marekw1986/Z80_computer/hardware/CPU_board/Z80.brd

## EAGLE design hardware/CPU_board/Z80.brd (2025-04-28)

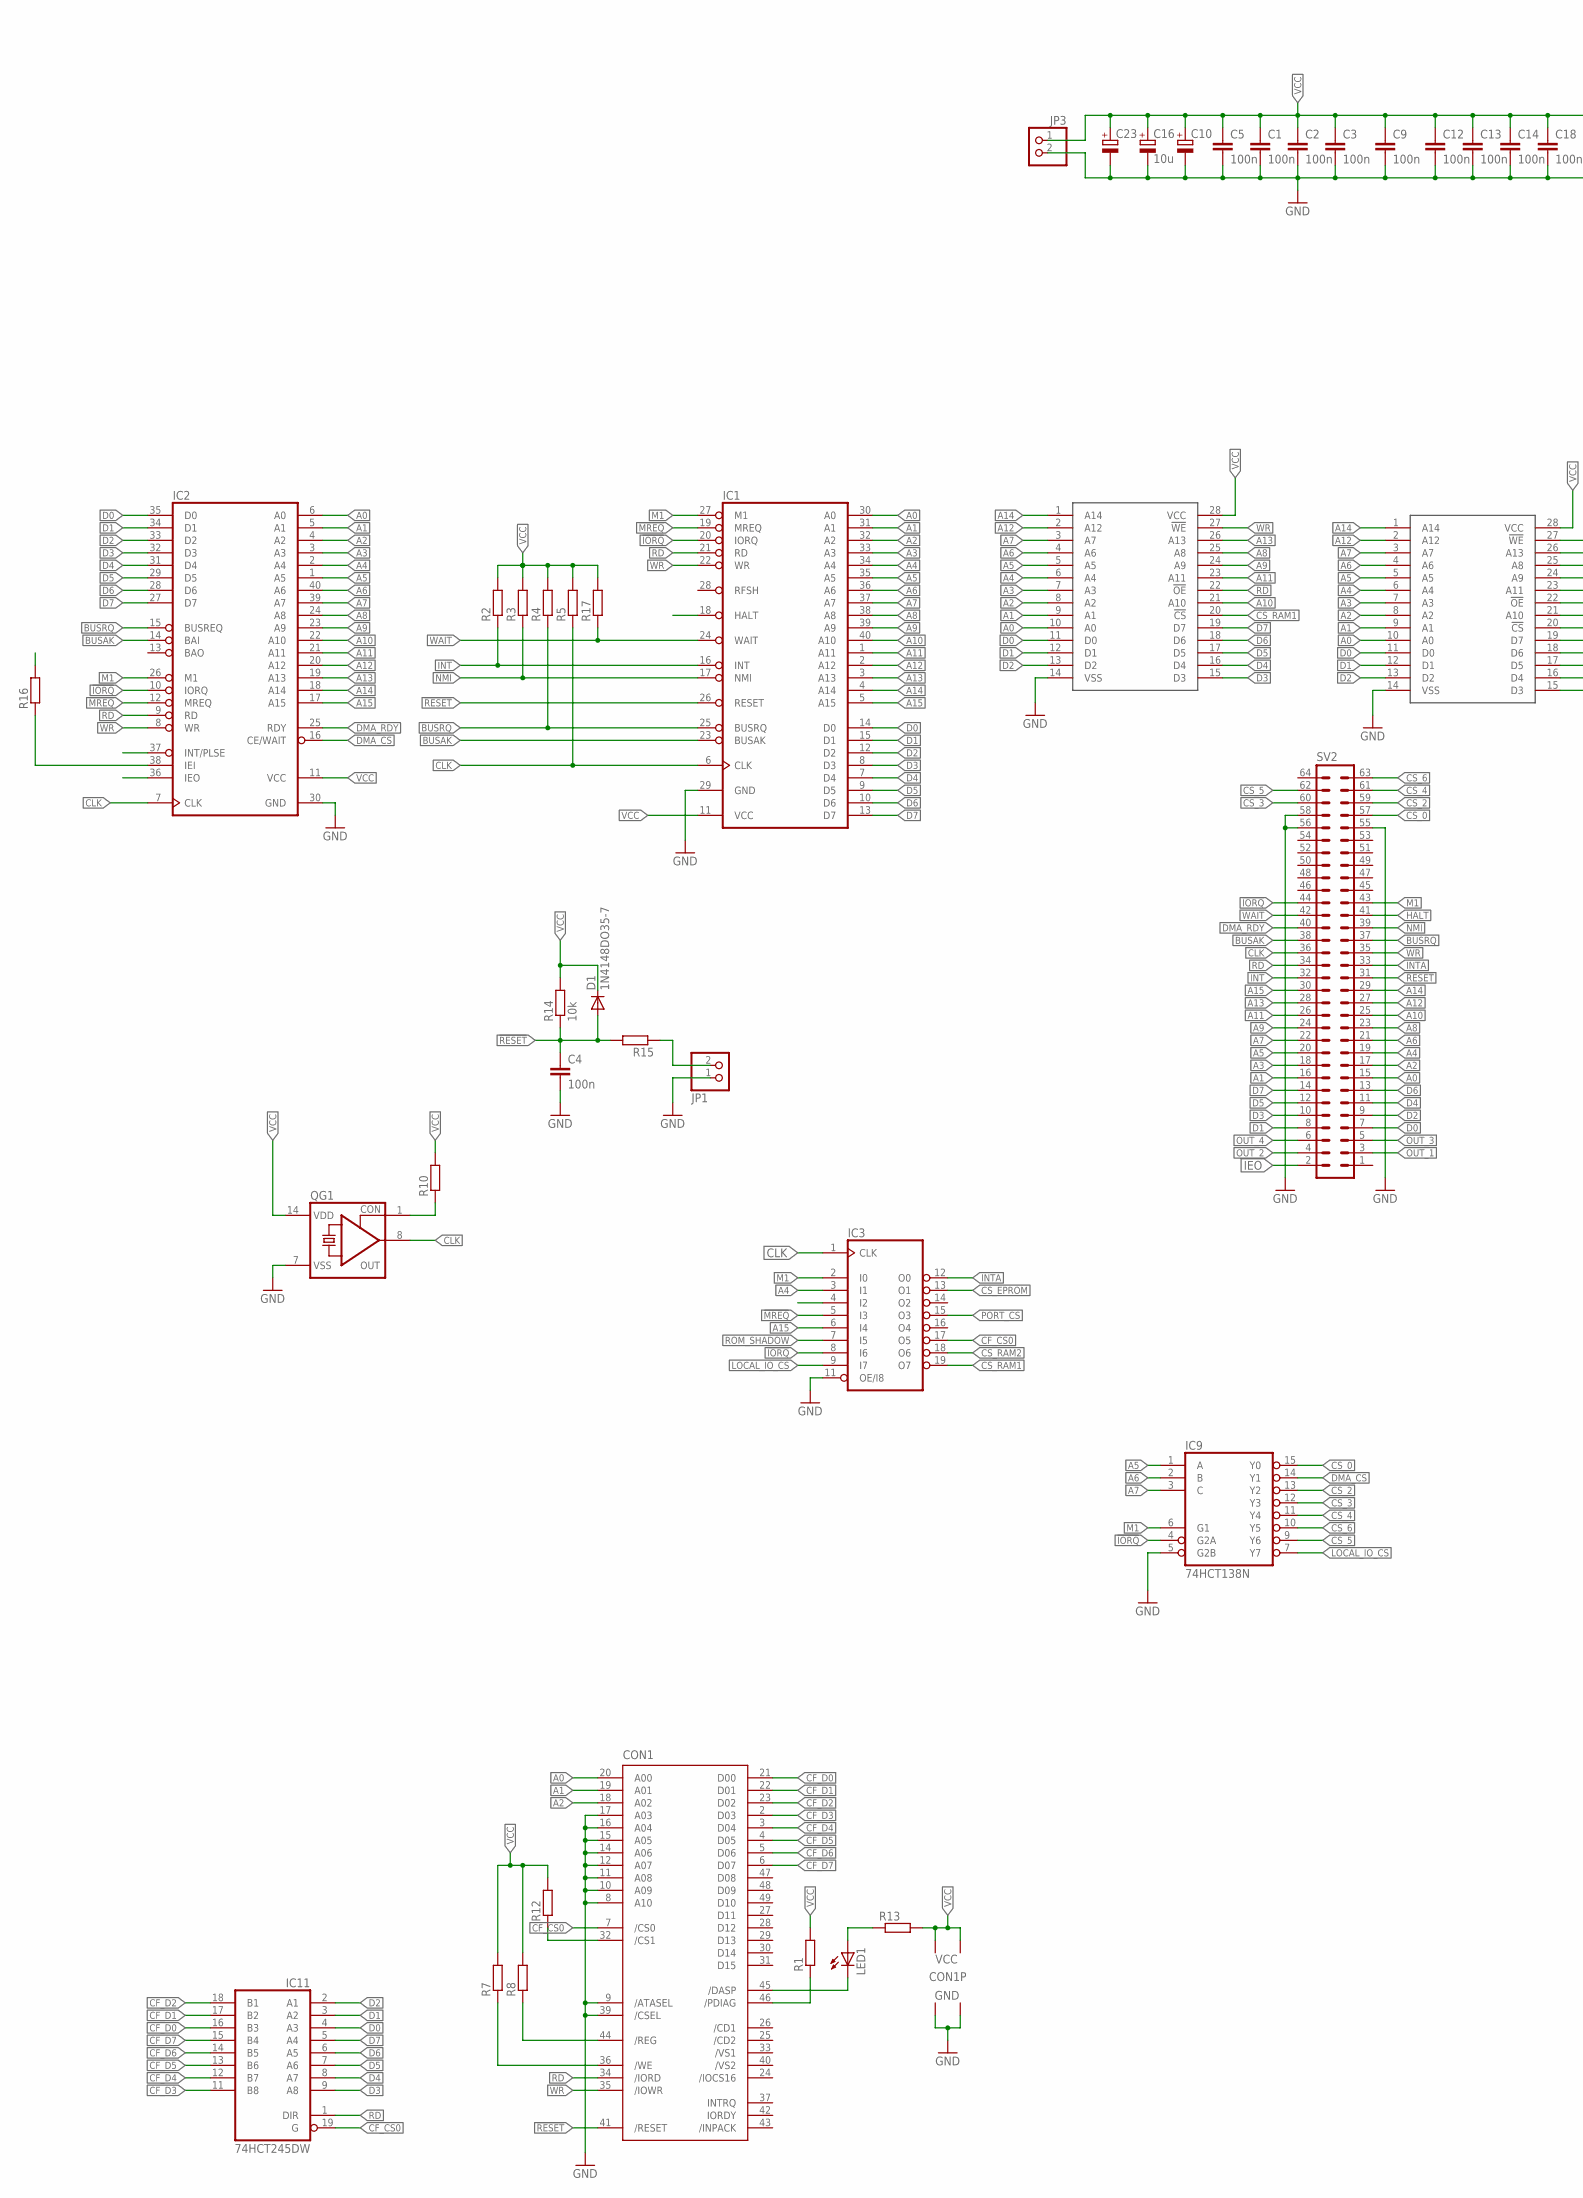
[picture p1: schematic Z80.sch, part in row 1, column 1]

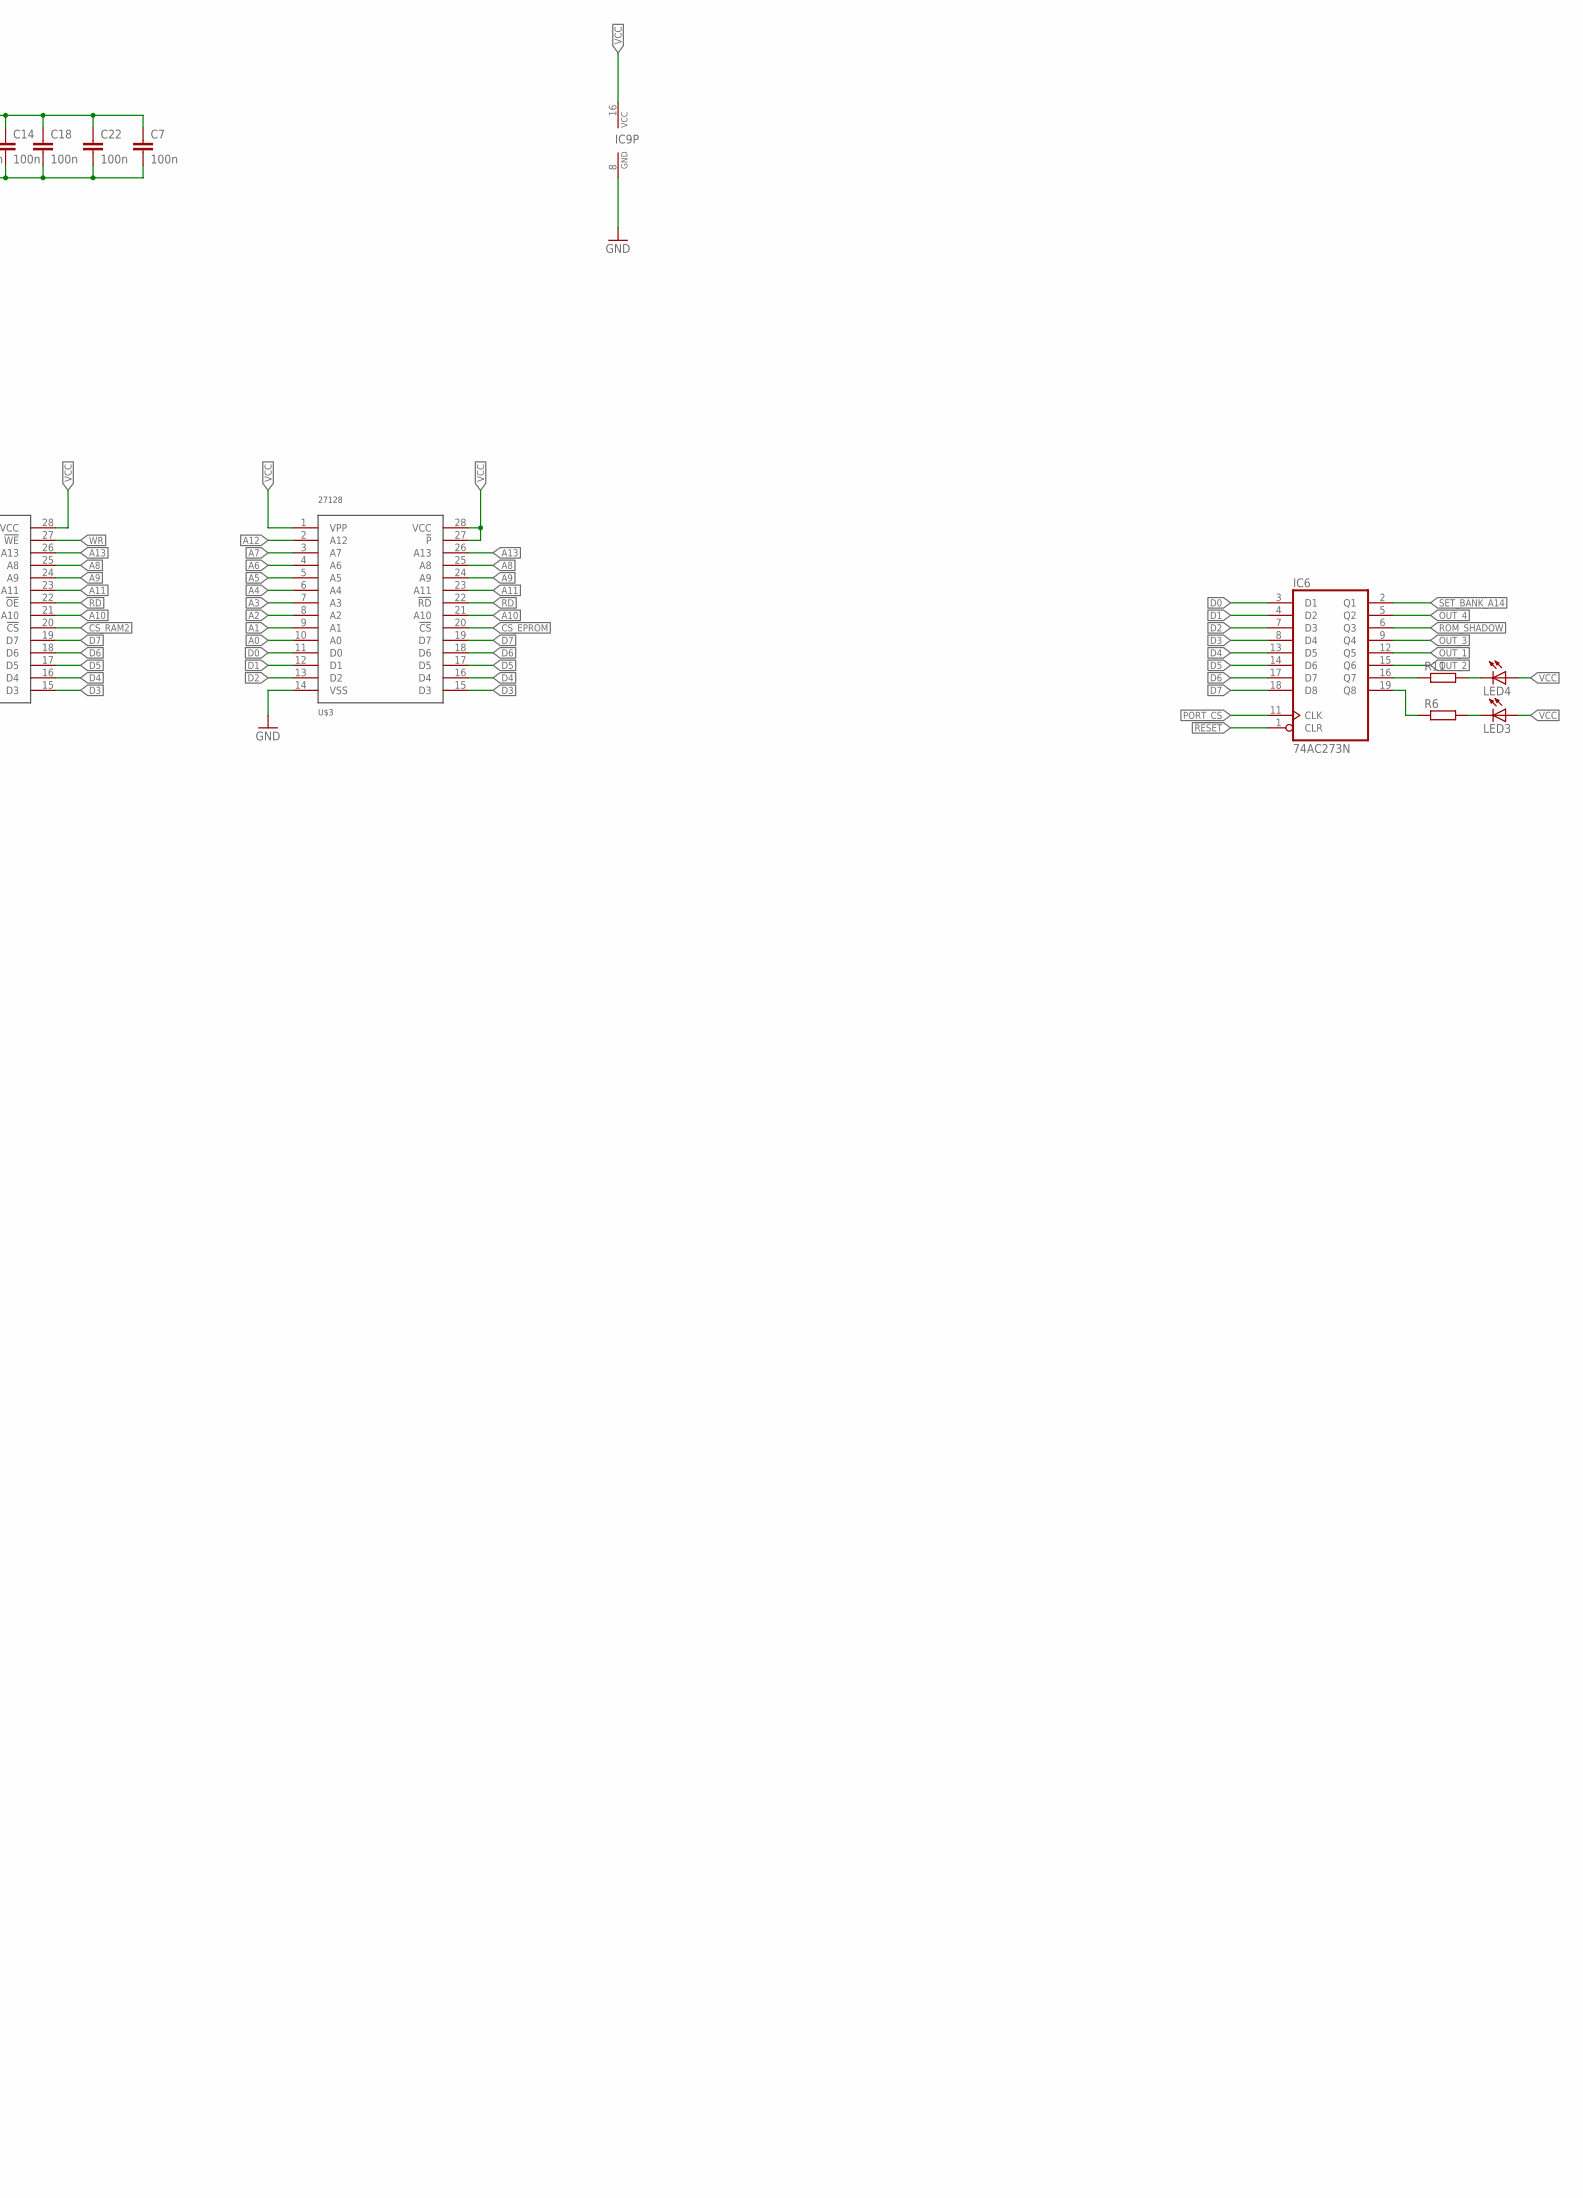
[picture p2: schematic Z80.sch, part in row 1, column 2]

Parts:
C1, C2, C3, C9, C14: 100n; C1206
C4, C7, C18, C22: 100n; C0603
C5: 100n; C050-024X044
C10, C23: CPOL-EUE5-10.5; E5-10,5
C12, C13: 100n; C0805
C16: 10u; SMC_B
CON1: CF-CARD-IDE_MODE; MI20-50PD-SF
D1: 1N4148DO35-7; DO35-7
IC1: Z80CPU; DIL40
IC2: Z80DMA; DIL40
IC3: 16V8; DIL20
IC6: 74AC273N; DIL20
IC9: 74HCT138N; DIL16
IC11: 74HCT245DW; SO20W
JP1, JP3: PINHD-1X2; 1X02
LED1, LED3, LED4: LED5MM
QG1: CRYSTAL_RES-SG51; SG51
R1, R8: R-EU_0204/7; 0204/7
R2, R3, R6, R11: R-EU_R1206; R1206
R4, R5, R10, R13, R15, R17: R-EU_R0603; R0603
R7, R12: R-EU_0207/10; 0207/10
R14: 10k; 0204/7
R16: R-EU_0204/5; 0204/5
SV2: ML64L
U$2, U$4: 62256; DIL28-6
U$3: 27128; DIL28

Connections:
!IORQ: IC1.20 (IORQ), IC2.10 (IORQ), IC3.8 (I6), IC9.4 (G2A), SV2.44
!MREQ: IC1.19 (MREQ), IC2.12 (MREQ), IC3.5 (I3)
!RESET: C4.1, CON1.41 (/RESET), D1.A, IC1.26 (RESET), IC6.1 (CLR), R14.1, R15.2, SV2.31
A0: CON1.20 (A00), IC1.30 (A0), IC2.6 (A0), SV2.15, U$2.10 (A0), U$3.10 (A0), U$4.10 (A0)
A1: CON1.19 (A01), IC1.31 (A1), IC2.5 (A1), SV2.16, U$2.9 (A1), U$3.9 (A1), U$4.9 (A1)
A2: CON1.18 (A02), IC1.32 (A2), IC2.4 (A2), SV2.17, U$2.8 (A2), U$3.8 (A2), U$4.8 (A2)
A3: IC1.33 (A3), IC2.3 (A3), SV2.18, U$2.7 (A3), U$3.7 (A3), U$4.7 (A3)
A4: IC1.34 (A4), IC2.2 (A4), IC3.3 (I1), SV2.19, U$2.6 (A4), U$3.6 (A4), U$4.6 (A4)
A5: IC1.35 (A5), IC2.1 (A5), IC9.1 (A), SV2.20, U$2.5 (A5), U$3.5 (A5), U$4.5 (A5)
A6: IC1.36 (A6), IC2.40 (A6), IC9.2 (B), SV2.21, U$2.4 (A6), U$3.4 (A6), U$4.4 (A6)
A7: IC1.37 (A7), IC2.39 (A7), IC9.3 (C), SV2.22, U$2.3 (A7), U$3.3 (A7), U$4.3 (A7)
A8: IC1.38 (A8), IC2.24 (A8), SV2.23, U$2.25 (A8), U$3.25 (A8), U$4.25 (A8)
A9: IC1.39 (A9), IC2.23 (A9), SV2.24, U$2.24 (A9), U$3.24 (A9), U$4.24 (A9)
A10: IC1.40 (A10), IC2.22 (A10), SV2.25, U$2.21 (A10), U$3.21 (A10), U$4.21 (A10)
A11: IC1.1 (A11), IC2.21 (A11), SV2.26, U$2.23 (A11), U$3.23 (A11), U$4.23 (A11)
A12: IC1.2 (A12), IC2.20 (A12), SV2.27, U$2.2 (A12), U$3.2 (A12), U$4.2 (A12)
A13: IC1.3 (A13), IC2.19 (A13), SV2.28, U$2.26 (A13), U$3.26 (A13), U$4.26 (A13)
A14: IC1.4 (A14), IC2.18 (A14), SV2.29, U$2.1 (A14), U$4.1 (A14)
A15: IC1.5 (A15), IC2.17 (A15), IC3.6 (I4), SV2.30
BUSAK: IC1.23 (BUSAK), IC2.14 (BAI), SV2.38
BUSRQ: IC1.25 (BUSRQ), IC2.15 (BUSREQ), R4.1, SV2.37
CF_CS0: CON1.7 (/CS0), IC3.17 (O5), IC11.19 (G)
CF_D0: CON1.21 (D00), IC11.16 (B3)
CF_D1: CON1.22 (D01), IC11.17 (B2)
CF_D2: CON1.23 (D02), IC11.18 (B1)
CF_D3: CON1.2 (D03), IC11.11 (B8)
CF_D4: CON1.3 (D04), IC11.12 (B7)
CF_D5: CON1.4 (D05), IC11.13 (B6)
CF_D6: CON1.5 (D06), IC11.14 (B5)
CF_D7: CON1.6 (D07), IC11.15 (B4)
CLK: IC1.6 (CLK), IC2.7 (CLK), IC3.1 (CLK), QG1.8 (OUT), R5.1, SV2.36
CS_0: IC9.15 (Y0), SV2.57
CS_2: IC9.13 (Y2), SV2.59
CS_3: IC9.12 (Y3), SV2.60
CS_4: IC9.11 (Y4), SV2.61
CS_5: IC9.9 (Y6), SV2.62
CS_6: IC9.10 (Y5), SV2.63
CS_EPROM: IC3.13 (O1), U$3.20 (!CS)
CS_RAM1: IC3.19 (O7), U$4.20 (!CS)
CS_RAM2: IC3.18 (O6), U$2.20 (!CS)
D0: IC1.14 (D0), IC2.35 (D0), IC6.3 (D1), IC11.4 (A3), SV2.7, U$2.11 (D0), U$3.11 (D0), U$4.11 (D0)
D1: IC1.15 (D1), IC2.34 (D1), IC6.4 (D2), IC11.3 (A2), SV2.8, U$2.12 (D1), U$3.12 (D1), U$4.12 (D1)
D2: IC1.12 (D2), IC2.33 (D2), IC6.7 (D3), IC11.2 (A1), SV2.9, U$2.13 (D2), U$3.13 (D2), U$4.13 (D2)
D3: IC1.8 (D3), IC2.32 (D3), IC6.8 (D4), IC11.9 (A8), SV2.10, U$2.15 (D3), U$3.15 (D3), U$4.15 (D3)
D4: IC1.7 (D4), IC2.31 (D4), IC6.13 (D5), IC11.8 (A7), SV2.11, U$2.16 (D4), U$3.16 (D4), U$4.16 (D4)
D5: IC1.9 (D5), IC2.29 (D5), IC6.14 (D6), IC11.7 (A6), SV2.12, U$2.17 (D5), U$3.17 (D5), U$4.17 (D5)
D6: IC1.10 (D6), IC2.28 (D6), IC6.17 (D7), IC11.6 (A5), SV2.13, U$2.18 (D6), U$3.18 (D6), U$4.18 (D6)
D7: IC1.13 (D7), IC2.27 (D7), IC6.18 (D8), IC11.5 (A4), SV2.14, U$2.19 (D7), U$3.19 (D7), U$4.19 (D7)
DMA_CS: IC2.16 (CE/WAIT), IC9.14 (Y1)
DMA_RDY: IC2.25 (RDY), SV2.40
GND: C1.2, C2.2, C3.2, C4.2, C5.2, C7.2, C9.2, C10.-, C12.2, C13.2, C14.2, C16.-, C18.2, C22.2, C23.-, CON1.1 (GND1), CON1.8 (A10), CON1.9 (/ATASEL), CON1.10 (A09), CON1.11 (A08), CON1.12 (A07), CON1.14 (A06), CON1.15 (A05), CON1.16 (A04), CON1.17 (A03), CON1.39 (/CSEL), CON1.50 (GND2), IC1.29 (GND), IC2.30 (GND), IC3.10 (GND), IC3.11 (OE/I8), IC6.10 (GND), IC9.5 (G2B), IC9.8 (GND), IC11.10 (GND), JP1.1, JP3.2, QG1.7 (VSS), SV2.55, SV2.56, SV2.58, U$2.14 (VSS), U$3.14 (VSS), U$4.14 (VSS)
HALT: IC1.18 (HALT), SV2.41
IEO: IC2.36 (IEO), SV2.2
INT: IC1.16 (INT), IC2.37 (INT/PLSE), R2.1, SV2.32
INTA: IC3.12 (O0), SV2.33
LOCAL_IO_CS: IC3.9 (I7), IC9.7 (Y7)
M1: IC1.27 (M1), IC2.26 (M1), IC3.2 (I0), IC9.6 (G1), SV2.43
unnamed: QG1.1 (CON), R10.1
unnamed: JP1.2, R15.1
unnamed: IC2.38 (IEI), R16.1
unnamed: IC6.16 (Q7), R11.1
unnamed: LED3.K (C), R6.2
unnamed: LED4.K (C), R11.2
unnamed: IC6.19 (Q8), R6.1
unnamed: CON1.44 (/REG), R8.1
unnamed: CON1.36 (/WE), R7.1
unnamed: CON1.46 (/PDIAG), R1.1
unnamed: LED1.A, R13.1
unnamed: CON1.45 (/DASP), LED1.K (C)
unnamed: CON1.32 (/CS1), R12.1
NMI: IC1.17 (NMI), R3.1, SV2.39
OUT_1: IC6.12 (Q5), SV2.3
OUT_2: IC6.15 (Q6), SV2.4
OUT_3: IC6.9 (Q4), SV2.5
OUT_4: IC6.5 (Q2), SV2.6
PORT_CS: IC3.15 (O3), IC6.11 (CLK)
RD: CON1.34 (/IORD), IC1.21 (RD), IC2.9 (RD), IC11.1 (DIR), SV2.34, U$2.22 (!OE), U$3.22 (!RD), U$4.22 (!OE)
ROM_SHADOW: IC3.7 (I5), IC6.6 (Q3)
SET_BANK_A14: IC6.2 (Q1)
VCC: C1.1, C2.1, C3.1, C5.1, C7.1, C9.1, C10.+, C12.1, C13.1, C14.1, C16.+, C18.1, C22.1, C23.+, CON1.13 (VCC2), CON1.38 (VCC1), D1.C, IC1.11 (VCC), IC2.11 (VCC), IC3.20 (VCC), IC6.20 (VCC), IC9.16 (VCC), IC11.20 (VCC), JP3.1, LED3.A, LED4.A, QG1.14 (VDD), R1.2, R2.2, R3.2, R4.2, R5.2, R7.2, R8.2, R10.2, R12.2, R13.2, R14.2, R16.2, R17.2, U$2.28 (VCC), U$3.1 (VPP), U$3.27 (!P), U$3.28 (VCC), U$4.28 (VCC)
WAIT: IC1.24 (WAIT), R17.1, SV2.42
WR: CON1.35 (/IOWR), IC1.22 (WR), IC2.8 (WR), IC3.4 (I2), SV2.35, U$2.27 (!WE), U$4.27 (!WE)

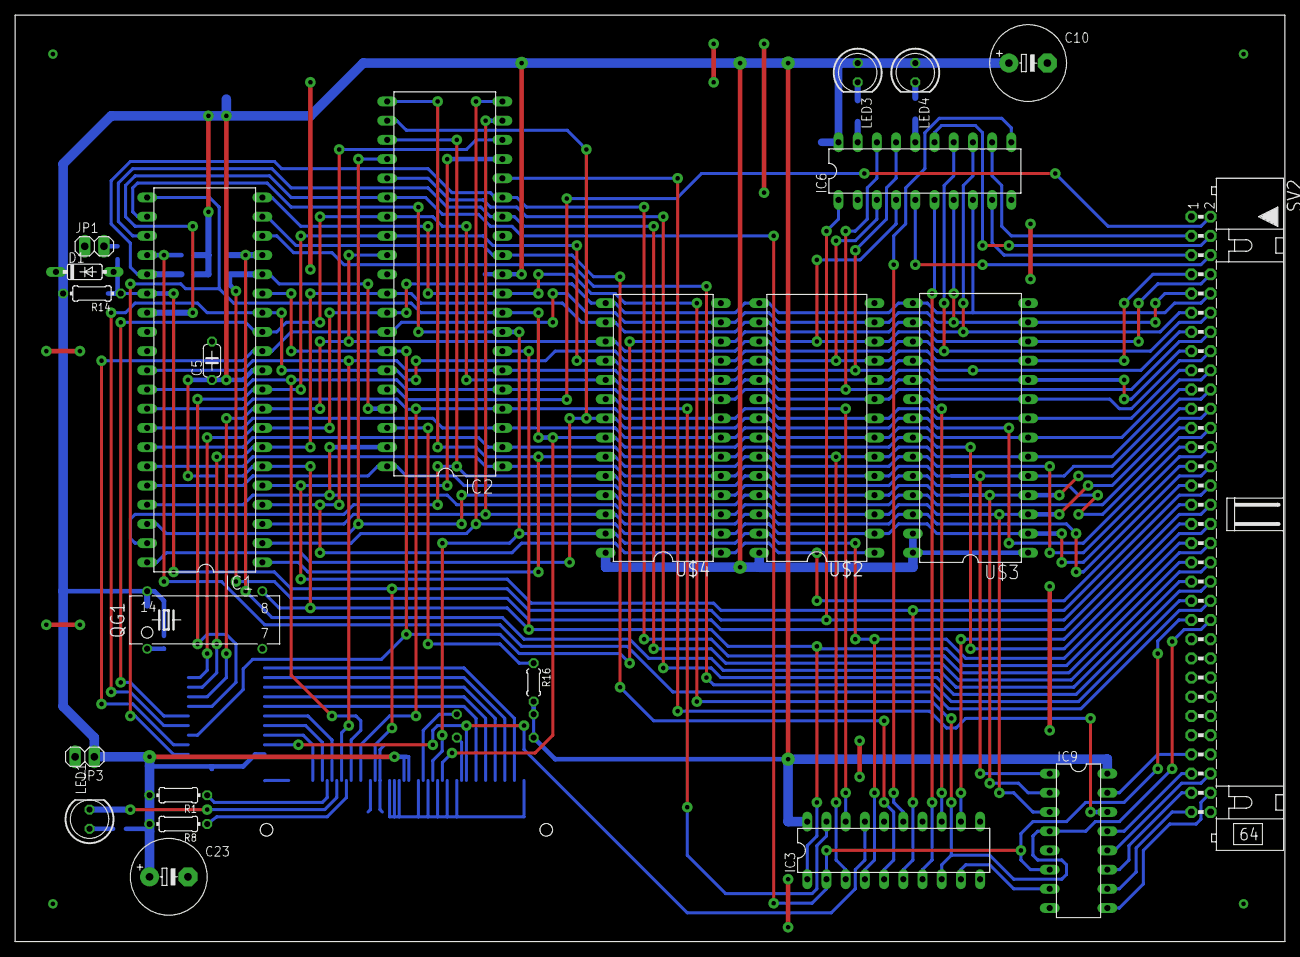
[picture p3: board Z80.brd from above]

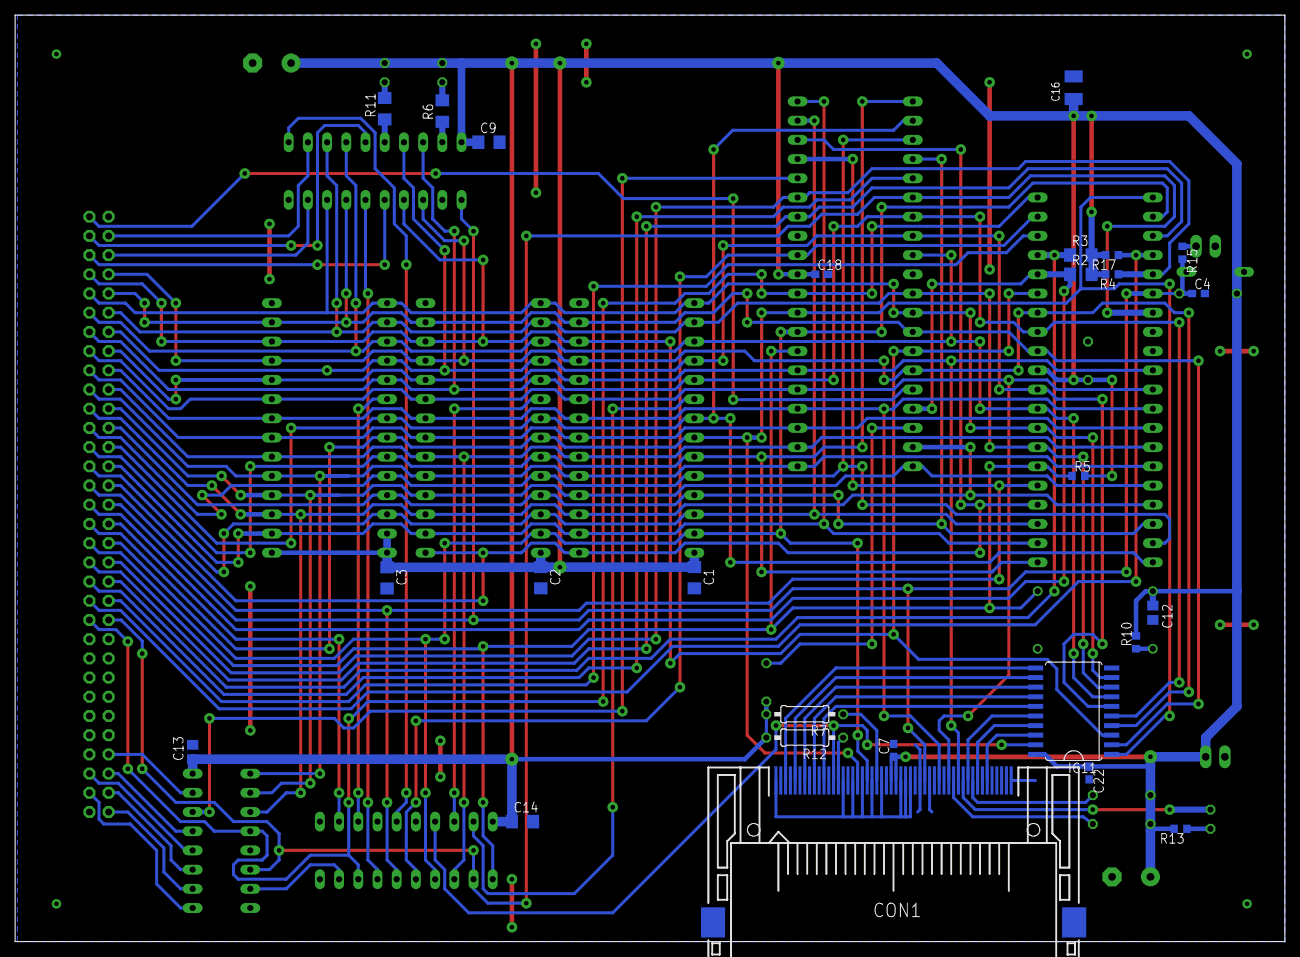
[picture p4: board Z80.brd from below]

Board: 2 copper layers, 167.9 x 122.5 mm, 49 parts (26 on the bottom side), 81 nets.
