marekw1986/Z80_computer/hardware/IO_board/IO.brd

## EAGLE design hardware/IO_board/IO.brd (2025-03-09)

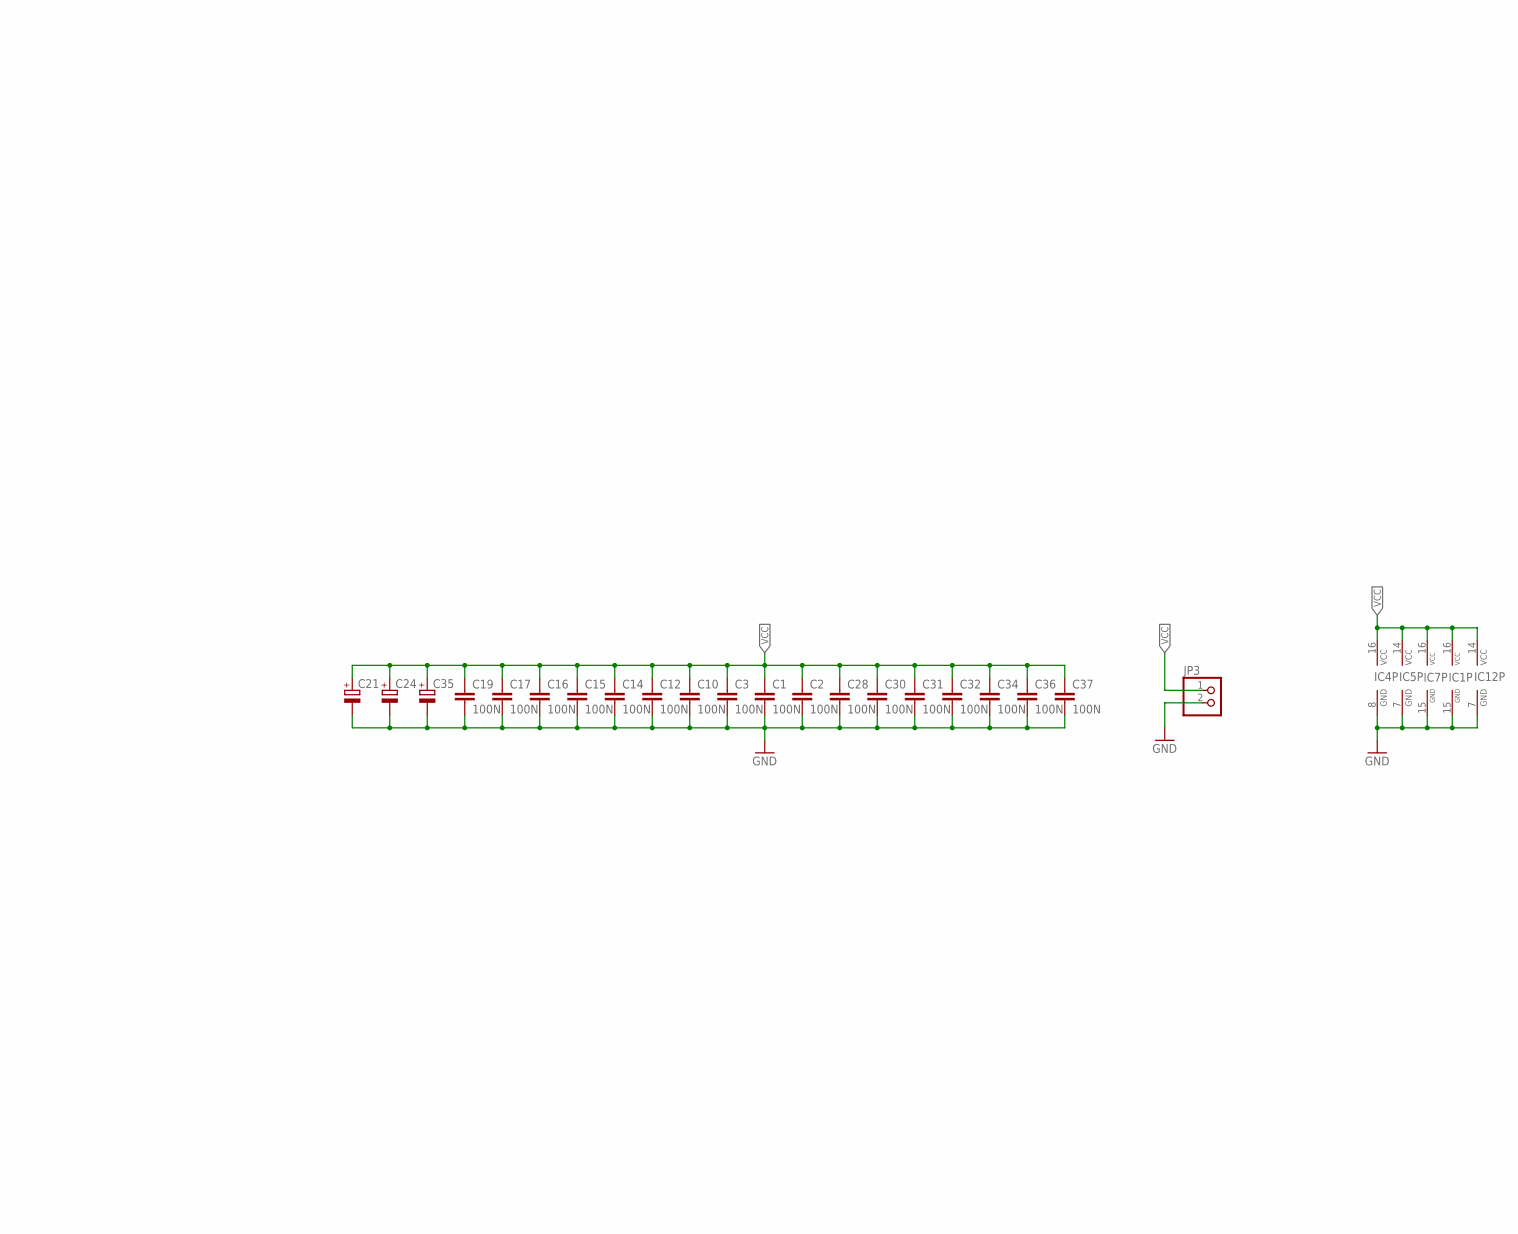
[picture p5: schematic IO.sch, part in row 1, column 1]

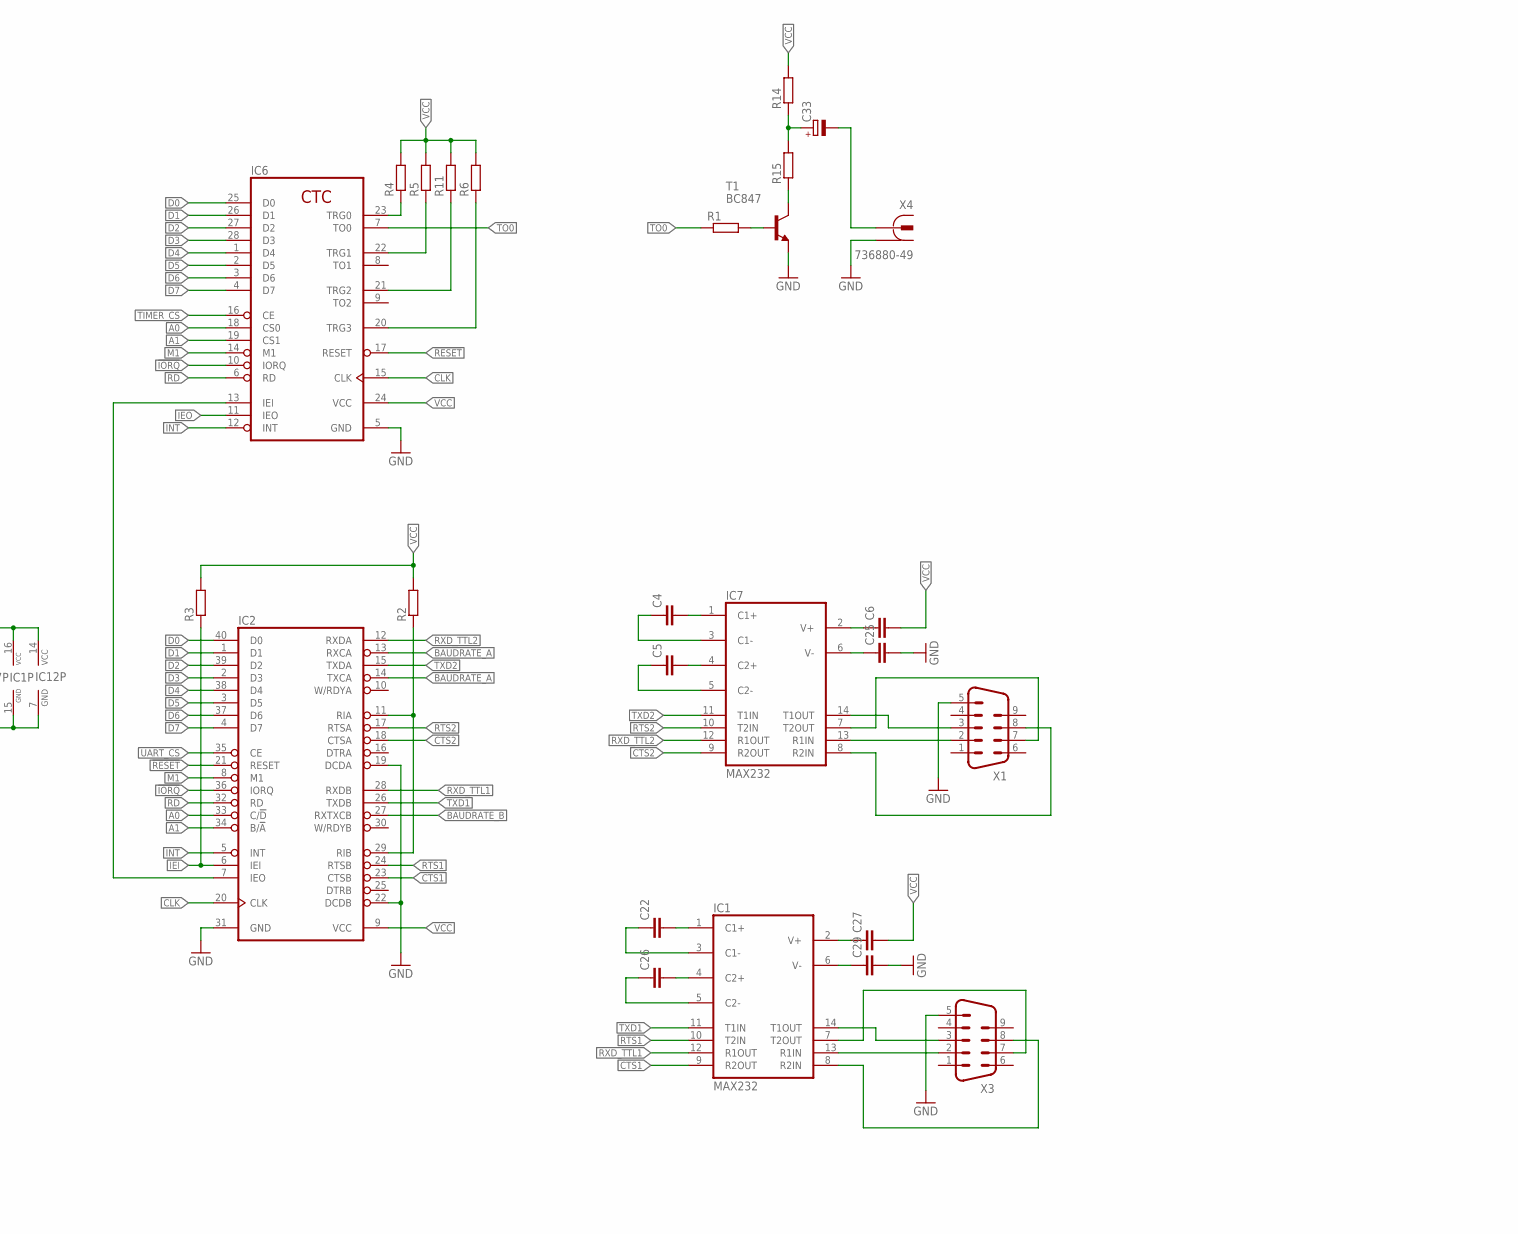
[picture p6: schematic IO.sch, part in row 1, column 2]

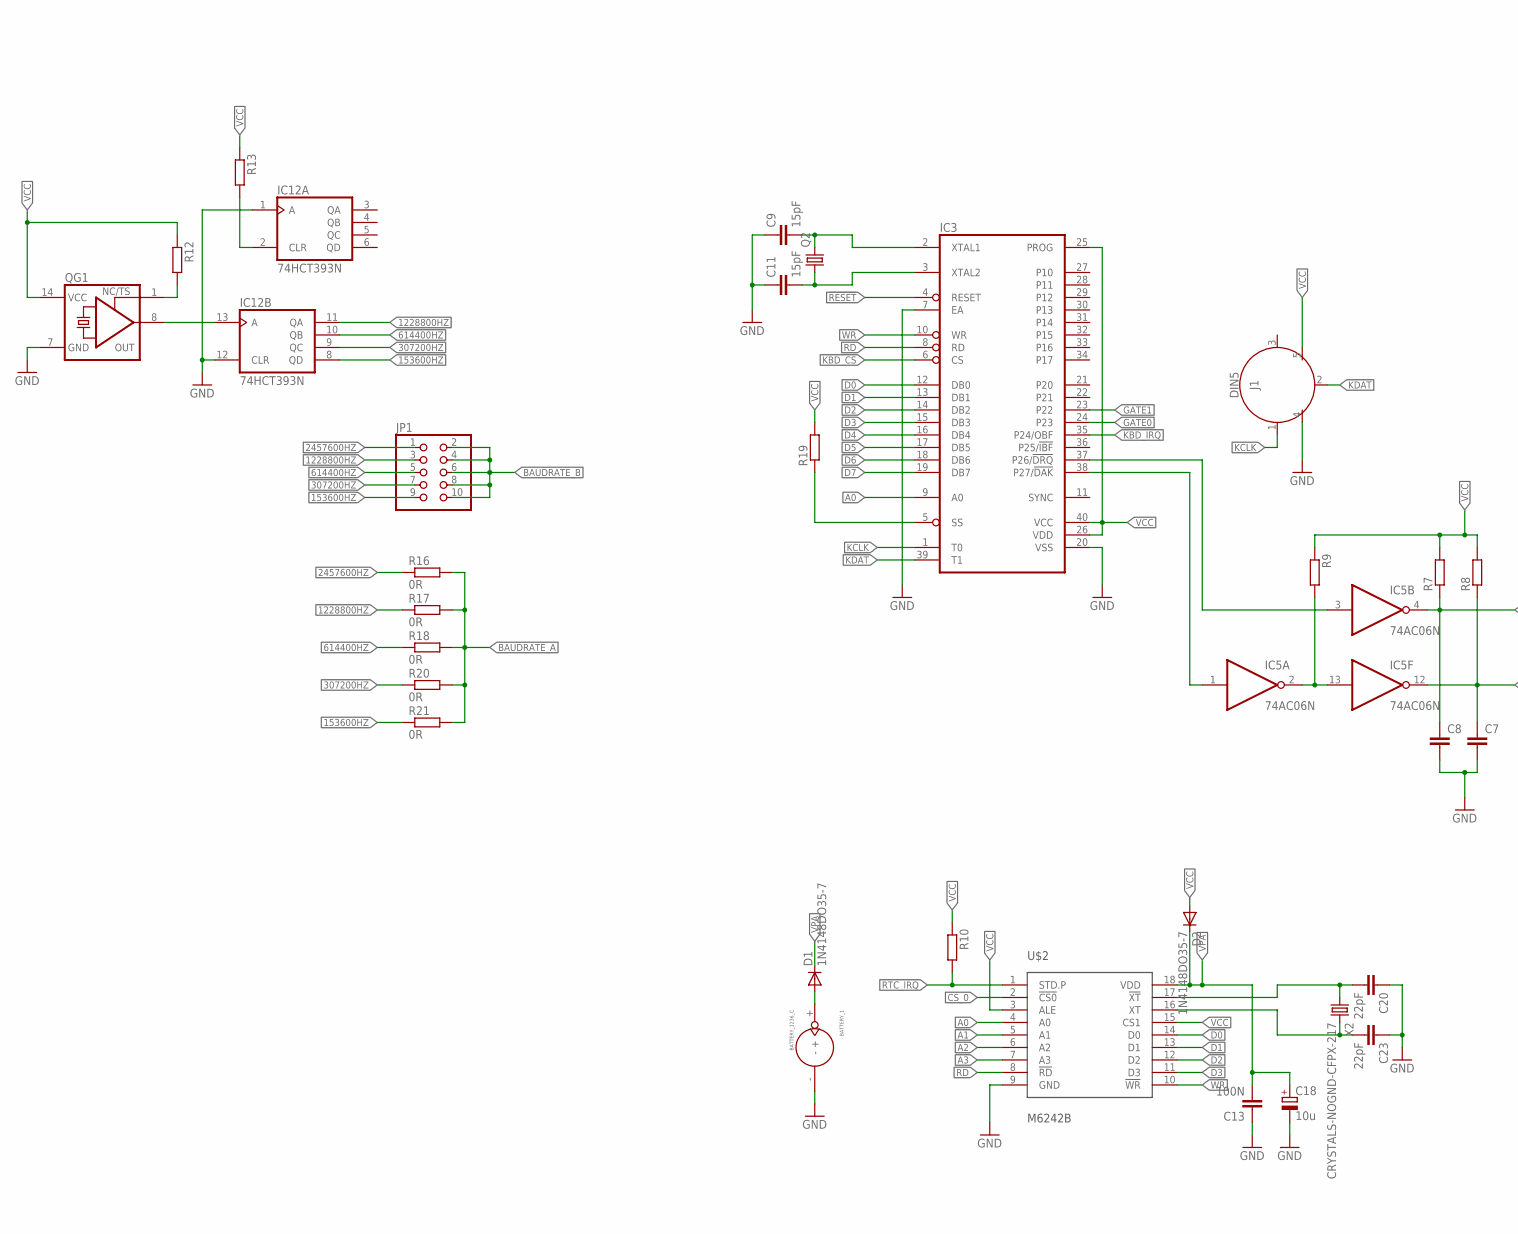
[picture p7: schematic IO.sch, part in row 2, column 1]

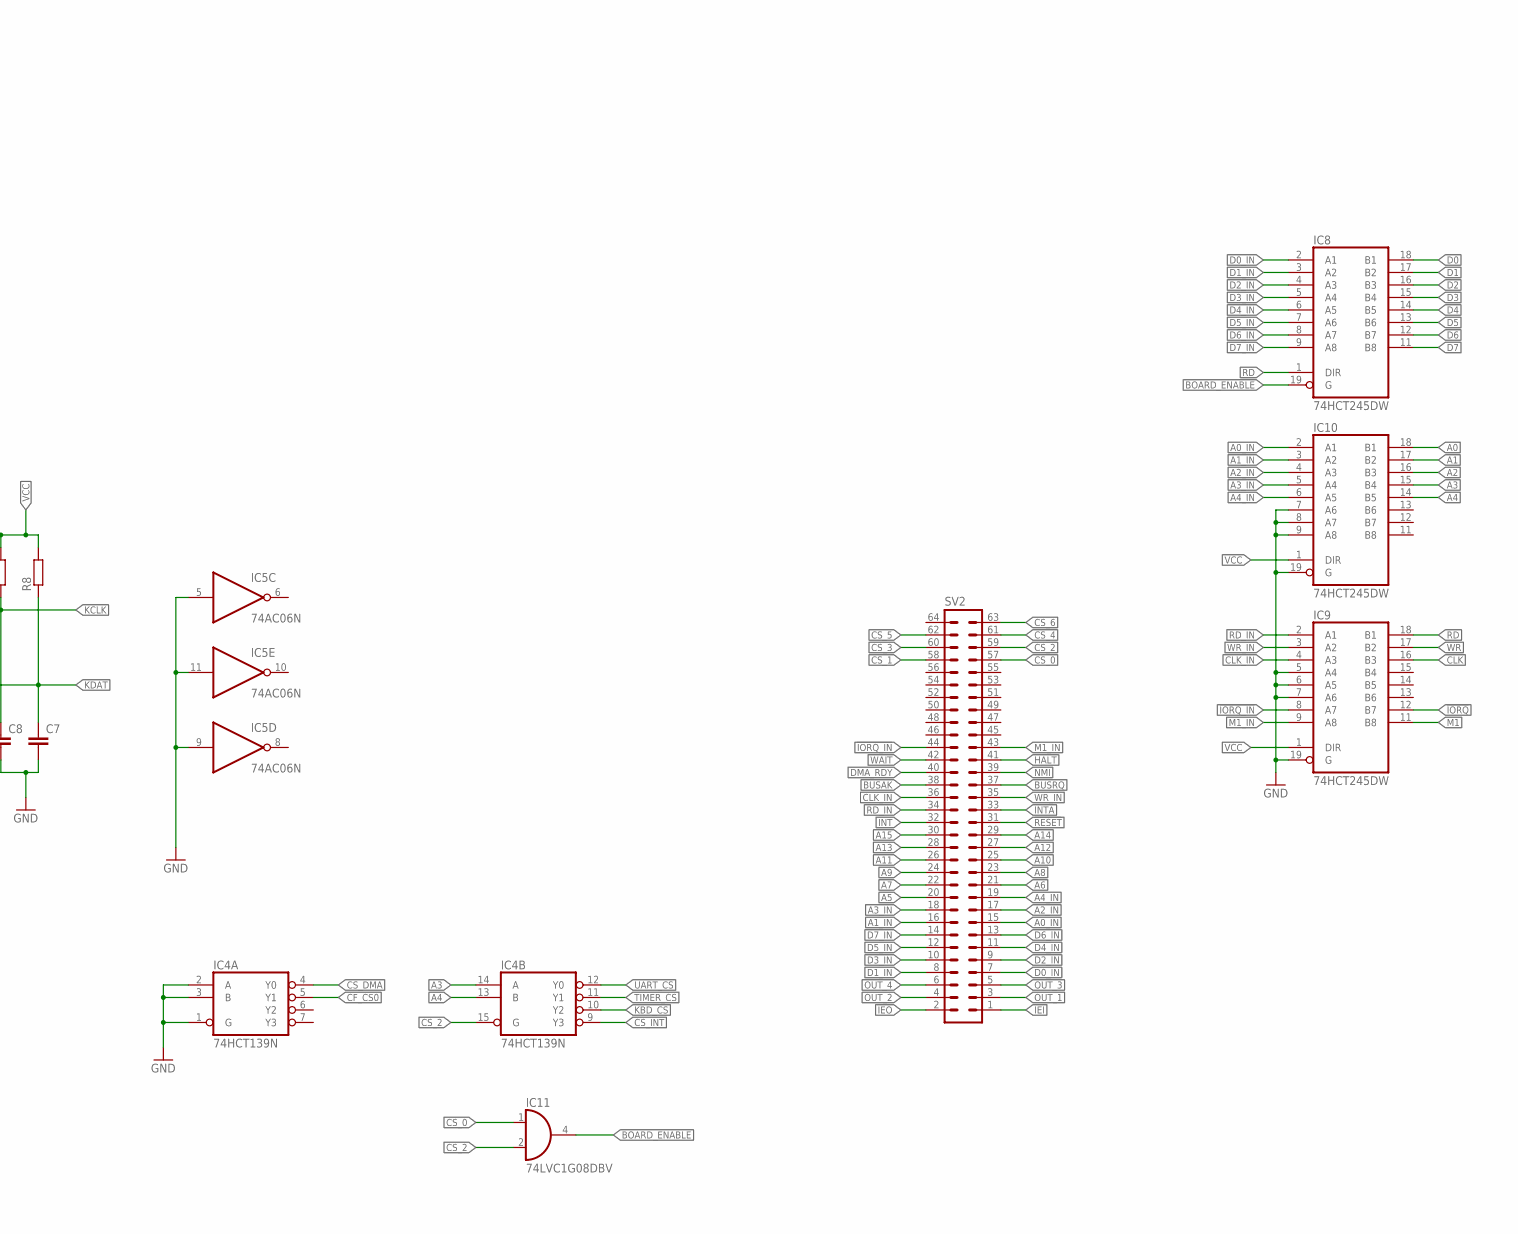
[picture p8: schematic IO.sch, part in row 2, column 2]

Parts:
BATTERY_1: BATTERY_1236_C
C1, C3, C10, C12, C13, C14, C15, C16, C17, C19, C28, C30, C31, C32, C34, C36, C37: 100N; C0603
C2: 100N; C1206
C4, C5, C6, C7, C8, C22, C25, C26, C27, C29: C-EUC0603; C0603
C9, C11: 15pF; C0603
C18: 10u; SMC_B
C20, C23: 22pF; C0603
C21, C24: CPOL-EUSMCB; SMC_B
C33: CPOL-EUE2-4; E2-4
C35: CPOL-EUE5-10.5; E5-10,5
D1, D2: 1N4148DO35-7; DO35-7
IC1, IC7: MAX232; DIL16
IC2: Z80DART; DIL40
IC3: UPI-8042AH; DIL40
IC4: 74HCT139N; DIL16
IC5: 74AC06N; DIL14
IC6: Z80CTC; DIL28
IC8, IC9, IC10: 74HCT245DW; SO20W
IC11: 74LVC1G08DBV; SOT23-5
IC12: 74HCT393N; DIL14
J1: DIN5; DIN5-RA-PTH
JP1: PINHD-2X5; 2X05
JP3: PINHD-1X2/90; 1X02/90
Q2: CRYSTALHC49S; HC49/S
QG1: XO-14; DIL14S
R1, R2, R4, R5, R9, R10, R11, R12, R13, R15: R-EU_R0603; R0603
R3, R6, R19: R-EU_0204/5; 0204/5
R7, R14: R-EU_0204/7; 0204/7
R8: R-EU_M0805; M0805
R16, R17, R18, R20, R21: 0R; R0603
SV2: ML64L
T1: BC847; SOT23
U$2: M6242B; DIL18
X1, X3: M09HP
X2: CRYSTALS-NOGND-CFPX-217; 3.2X1.5-2-PAD
X4: 736880-49

Connections:
153600HZ: IC12.8 (QD), JP1.9, R21.1
307200HZ: IC12.9 (QC), JP1.7, R20.1
614400HZ: IC12.10 (QB), JP1.5, R18.1
1228800HZ: IC12.11 (QA), JP1.3, R17.1
2457600HZ: IC12.13 (A), JP1.1, QG1.8 (OUT), R16.1
!IORQ: IC2.36 (IORQ), IC6.10 (IORQ), IC9.12 (B7)
!IORQ_IN: IC9.8 (A7), SV2.44
!RESET: IC2.21 (RESET), IC3.4 (RESET), IC6.17 (RESET), SV2.31
A0: IC2.33 (C/!D), IC3.9 (A0), IC6.18 (CS0), IC10.18 (B1), U$2.4 (A0)
A0_IN: IC10.2 (A1), SV2.15
A1: IC2.34 (B/!A), IC6.19 (CS1), IC10.17 (B2), U$2.5 (A1)
A1_IN: IC10.3 (A2), SV2.16
A2: IC10.16 (B3), U$2.6 (A2)
A2_IN: IC10.4 (A3), SV2.17
A3: IC4.14 (A), IC10.15 (B4), U$2.7 (A3)
A3_IN: IC10.5 (A4), SV2.18
A4: IC4.13 (B), IC10.14 (B5)
A4_IN: IC10.6 (A5), SV2.19
A5: SV2.20
A6: SV2.21
A7: SV2.22
A8: SV2.23
A9: SV2.24
A10: SV2.25
A11: SV2.26
A12: SV2.27
A13: SV2.28
A14: SV2.29
A15: SV2.30
BAUDRATE_A: IC2.13 (RXCA), IC2.14 (TXCA), R16.2, R17.2, R18.2, R20.2, R21.2
BAUDRATE_B: IC2.27 (RXTXCB), JP1.2, JP1.4, JP1.6, JP1.8, JP1.10
BOARD_ENABLE: IC8.19 (G), IC11.4 (O)
BUSAK: SV2.38
BUSRQ: SV2.37
CF_CS0: IC4.5 (Y1)
CLK: IC2.20 (CLK), IC6.15 (CLK), IC9.16 (B3)
CLK_IN: IC9.4 (A3), SV2.36
CS_0: IC11.1 (I0), SV2.57, U$2.2 (!CS0)
CS_1: SV2.58
CS_2: IC4.15 (G), IC11.2 (I1), SV2.59
CS_3: SV2.60
CS_4: SV2.61
CS_5: SV2.62
CS_6: SV2.63
CS_DMA: IC4.4 (Y0)
CS_INT: IC4.9 (Y3)
CTS1: IC1.9 (R2OUT), IC2.23 (CTSB)
CTS1_IN: IC1.8 (R2IN), X3.8
CTS2: IC2.18 (CTSA), IC7.9 (R2OUT)
D0: IC2.40 (D0), IC3.12 (DB0), IC6.25 (D0), IC8.18 (B1), U$2.14 (D0)
D0_IN: IC8.2 (A1), SV2.7
D1: IC2.1 (D1), IC3.13 (DB1), IC6.26 (D1), IC8.17 (B2), U$2.13 (D1)
D1_IN: IC8.3 (A2), SV2.8
D2: IC2.39 (D2), IC3.14 (DB2), IC6.27 (D2), IC8.16 (B3), U$2.12 (D2)
D2_IN: IC8.4 (A3), SV2.9
D3: IC2.2 (D3), IC3.15 (DB3), IC6.28 (D3), IC8.15 (B4), U$2.11 (D3)
D3_IN: IC8.5 (A4), SV2.10
D4: IC2.38 (D4), IC3.16 (DB4), IC6.1 (D4), IC8.14 (B5)
D4_IN: IC8.6 (A5), SV2.11
D5: IC2.3 (D5), IC3.17 (DB5), IC6.2 (D5), IC8.13 (B6)
D5_IN: IC8.7 (A6), SV2.12
D6: IC2.37 (D6), IC3.18 (DB6), IC6.3 (D6), IC8.12 (B7)
D6_IN: IC8.8 (A7), SV2.13
D7: IC2.4 (D7), IC3.19 (DB7), IC6.4 (D7), IC8.11 (B8)
D7_IN: IC8.9 (A8), SV2.14
DMA_RDY: SV2.40
GATE0: IC3.24 (P23)
GATE1: IC3.23 (P22)
GND: BATTERY_1.-, C1.2, C2.2, C3.2, C7.2, C8.2, C9.1, C10.2, C11.1, C12.2, C13.1, C14.2, C15.2, C16.2, C17.2, C18.-, C19.2, C20.1, C21.-, C23.1, C24.-, C25.2, C28.2, C29.2, C30.2, C31.2, C32.2, C34.2, C35.-, C36.2, C37.2, IC1.15 (GND), IC2.19 (DCDA), IC2.22 (DCDB), IC2.31 (GND), IC3.7 (EA), IC3.20 (VSS), IC4.1 (G), IC4.2 (A), IC4.3 (B), IC4.8 (GND), IC5.5 (I), IC5.7 (GND), IC5.9 (I), IC5.11 (I), IC6.5 (GND), IC7.15 (GND), IC8.10 (GND), IC9.5 (A4), IC9.6 (A5), IC9.7 (A6), IC9.10 (GND), IC9.19 (G), IC10.7 (A6), IC10.8 (A7), IC10.9 (A8), IC10.10 (GND), IC10.19 (G), IC11.3 (GND), IC12.1 (A), IC12.7 (GND), IC12.12 (CLR), J1.4, JP3.2, QG1.7 (GND), T1.2 (E), U$2.9 (GND), X1.5, X3.5, X4.1, X4.1@1 (1), X4.1@2 (1)
HALT: SV2.41
IEI: IC2.6 (IEI), R3.1, SV2.1
IEO: IC6.11 (IEO), SV2.2
INT: IC2.5 (INT), IC6.12 (INT), SV2.32
INTA: SV2.33
KBD_CS: IC3.6 (CS), IC4.10 (Y2)
KBD_IRQ: IC3.35 (P24/OBF)
KCLK: C8.1, IC3.1 (T0), IC5.4 (O), J1.1, R7.1
KDAT: C7.1, IC3.39 (T1), IC5.12 (O), J1.2, R8.1
M1: IC2.8 (M1), IC6.14 (M1), IC9.11 (B8)
M1_IN: IC9.9 (A8), SV2.43
unnamed: IC1.7 (T2OUT), X3.7
unnamed: C22.2, IC1.1 (C1+)
unnamed: IC3.38 (P27/!DAK), IC5.1 (I)
unnamed: C26.2, IC1.4 (C2+)
unnamed: C26.1, IC1.5 (C2-)
unnamed: C22.1, IC1.3 (C1-)
unnamed: IC7.7 (T2OUT), X1.7
unnamed: IC7.13 (R1IN), X1.2
unnamed: C4.2, IC7.1 (C1+)
unnamed: C5.2, IC7.4 (C2+)
unnamed: C5.1, IC7.5 (C2-)
unnamed: C4.1, IC7.3 (C1-)
unnamed: C6.1, IC7.2 (V+)
unnamed: C25.1, IC7.6 (V-)
unnamed: C9.2, IC3.2 (XTAL1), Q2.2
unnamed: C11.2, IC3.3 (XTAL2), Q2.1
unnamed: IC3.37 (P26/!DRQ), IC5.3 (I)
unnamed: IC7.14 (T1OUT), X1.3
unnamed: C27.1, IC1.2 (V+)
unnamed: IC5.2 (O), IC5.13 (I), R9.2
unnamed: IC1.13 (R1IN), X3.2
unnamed: BATTERY_1.+, D1.A
unnamed: R1.2, T1.1 (B)
unnamed: R15.1, T1.3 (C)
unnamed: IC7.8 (R2IN), X1.8
unnamed: C29.1, IC1.6 (V-)
unnamed: C33.-, X4.2
unnamed: IC6.22 (TRG1), R5.1
unnamed: IC2.7 (IEO), IC6.13 (IEI)
unnamed: IC6.23 (TRG0), R4.1
unnamed: QG1.1 (TS), R12.2
unnamed: IC3.5 (SS), R19.1
unnamed: IC2.11 (RIA), IC2.29 (RIB), R2.1
unnamed: IC6.20 (TRG3), R6.1
unnamed: IC6.21 (TRG2), R11.1
unnamed: C33.+, R14.1, R15.2
unnamed: IC12.2 (CLR), R13.2
NMI: SV2.39
OUT_1: SV2.3
OUT_2: SV2.4
OUT_3: SV2.5
OUT_4: SV2.6
RD: IC2.32 (RD), IC3.8 (RD), IC6.6 (RD), IC8.1 (DIR), IC9.18 (B1), U$2.8 (!RD)
RD_IN: IC9.2 (A1), SV2.34
RTC_IRQ: R10.2, U$2.1 (STD.P)
RTS1: IC1.10 (T2IN), IC2.24 (RTSB)
RTS2: IC2.17 (RTSA), IC7.10 (T2IN)
RXD_TTL1: IC1.12 (R1OUT), IC2.28 (RXDB)
RXD_TTL2: IC2.12 (RXDA), IC7.12 (R1OUT)
SOSCI: C20.2, U$2.17 (!XT), X2.1
SOSCO: C23.2, U$2.16 (XT), X2.2
TIMER_CS: IC4.11 (Y1), IC6.16 (CE)
TO0: IC6.7 (TO0), R1.1
TXD1: IC1.11 (T1IN), IC2.26 (TXDB)
TXD1_OUT: IC1.14 (T1OUT), X3.3
TXD2: IC2.15 (TXDA), IC7.11 (T1IN)
UART_CS: IC2.35 (CE), IC4.12 (Y0)
VCC: C1.1, C2.1, C3.1, C6.2, C10.1, C12.1, C14.1, C15.1, C16.1, C17.1, C19.1, C21.+, C24.+, C27.2, C28.1, C30.1, C31.1, C32.1, C34.1, C35.+, C36.1, C37.1, D2.A, IC1.16 (VCC), IC2.9 (VCC), IC3.25 (PROG), IC3.26 (VDD), IC3.40 (VCC), IC4.16 (VCC), IC5.14 (VCC), IC6.24 (VCC), IC7.16 (VCC), IC8.20 (VCC), IC9.1 (DIR), IC9.20 (VCC), IC10.1 (DIR), IC10.20 (VCC), IC11.5 (VCC), IC12.14 (VCC), J1.5, JP3.1, QG1.14 (VCC), R2.2, R3.2, R4.2, R5.2, R6.2, R7.2, R8.2, R9.1, R10.1, R11.2, R12.1, R13.1, R14.2, R19.2, U$2.3 (ALE), U$2.15 (CS1)
VPA: C13.2, C18.+, D1.C, D2.C, U$2.18 (VDD)
WAIT: SV2.42
WR: IC3.10 (WR), IC9.17 (B2), U$2.10 (!WR)
WR_IN: IC9.3 (A2), SV2.35

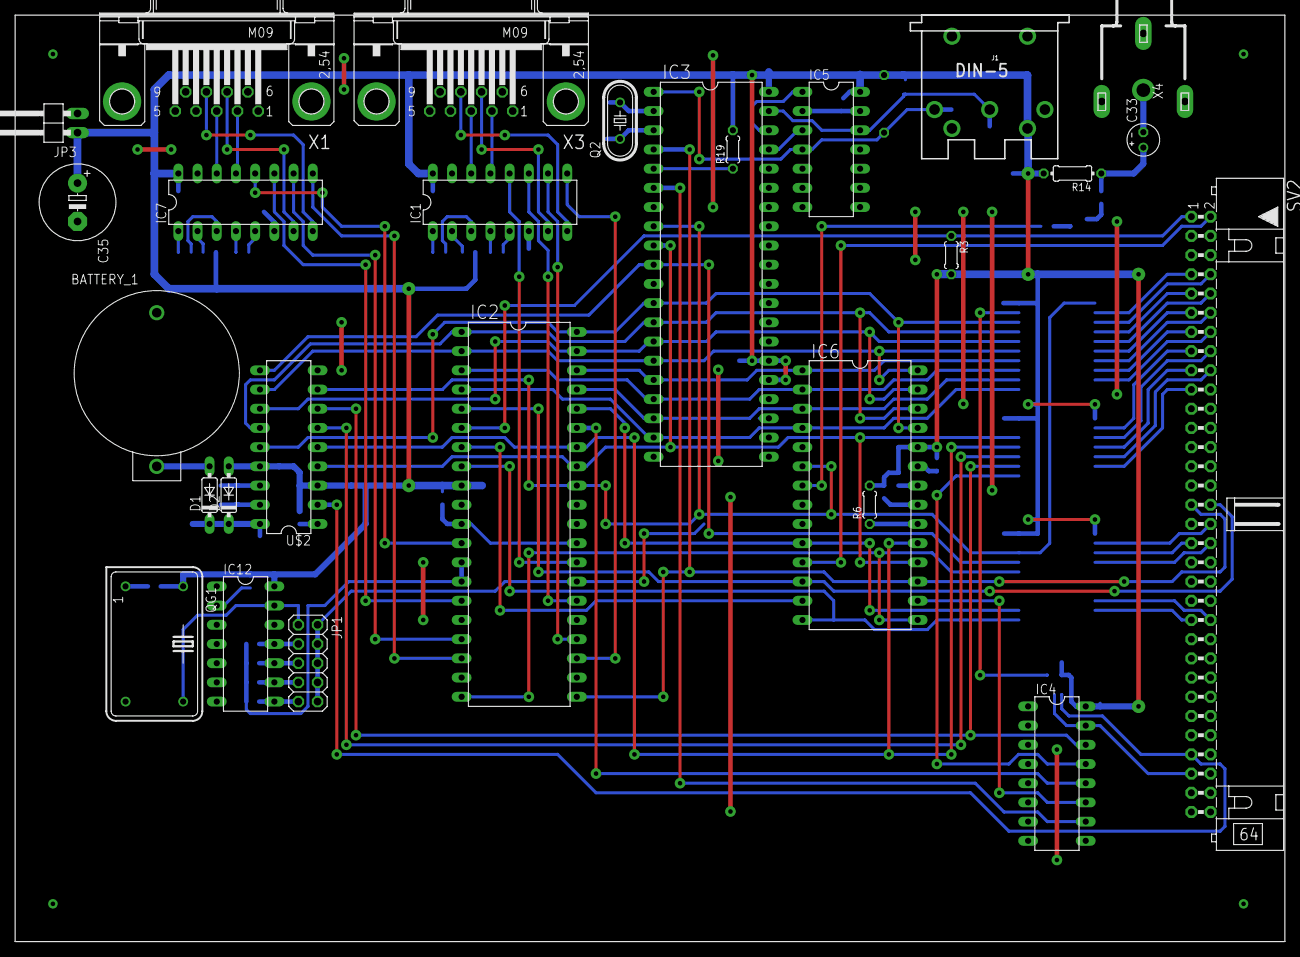
[picture p9: board IO.brd from above]

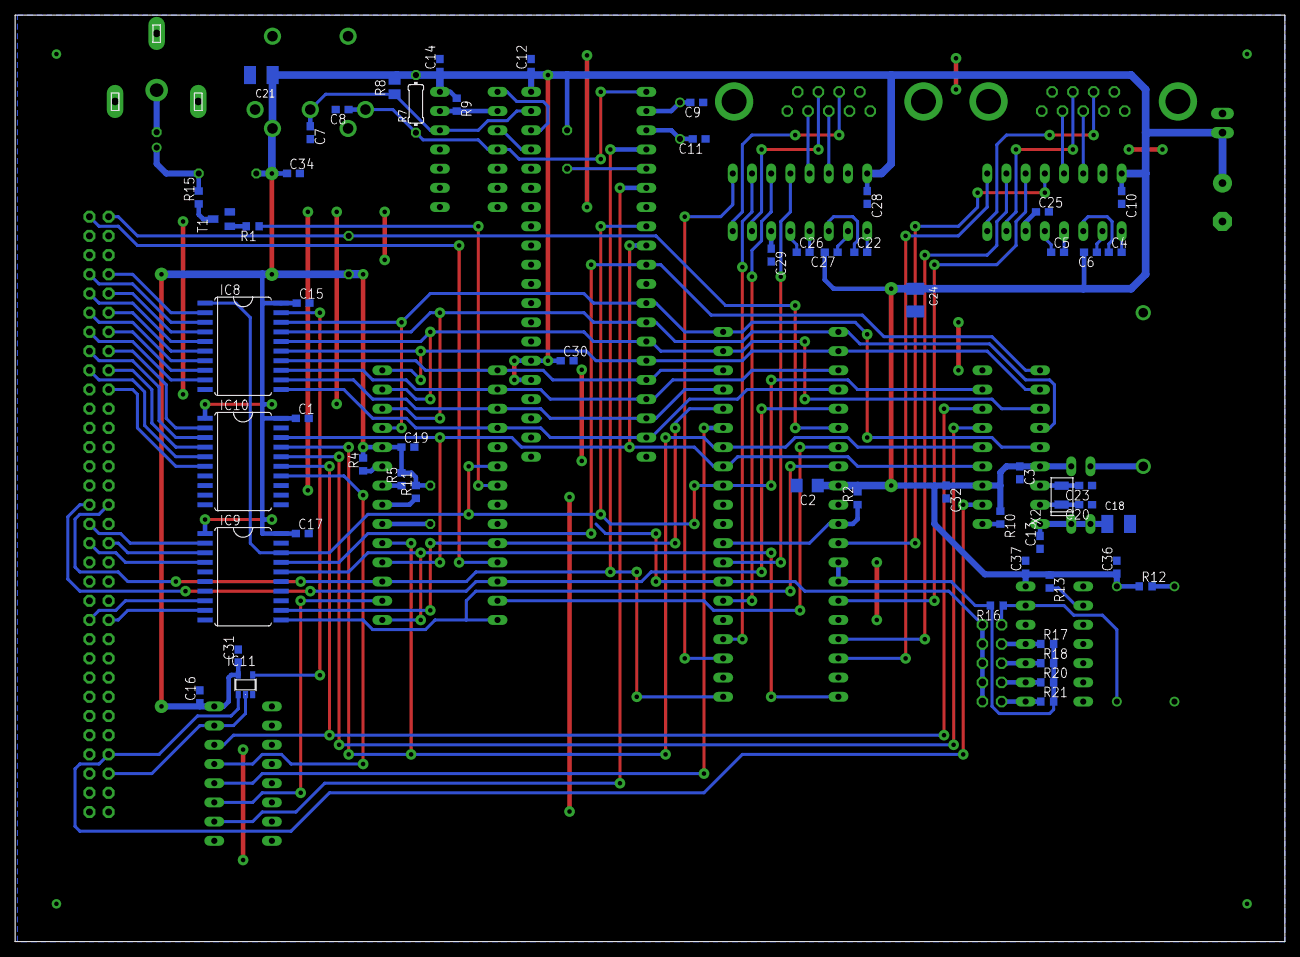
[picture p10: board IO.brd from below]

Board: 2 copper layers, 167.9 x 122.5 mm, 85 parts (58 on the bottom side), 109 nets.
