marekw1986/Z80_computer/(commit log)

2025-02-17 CPU board update
    [Z80.brd, Z80.sch]
2025-02-23 bugs in CPU board design fixed
    [Z80.brd, Z80.sch]
2025-02-25 I/O board added (work in progress)
    [IO.brd, IO.sch]
2025-02-26 CPU board and I/O board update
    [IO.brd, IO.sch, Z80.brd, Z80.sch]
2025-02-27 I/O board updated (work in progress)
    [IO.brd, IO.sch]
2025-02-27 IO board update (work in progress)
    [IO.brd, IO.sch]
2025-02-27 IO board update
    [IO.brd, IO.sch]
2025-02-28 CPU and I/O board update
    [IO.brd, IO.sch, Z80.brd, Z80.sch]
2025-03-01 Audio circuit added to I/O board
    [IO.brd, IO.sch]
2025-03-01 Capacitors added to I/O board
    [IO.brd, IO.sch]
2025-03-08 Separate baudrate generator on I/O board
    [IO.brd, IO.sch]
2025-03-09 I/O board: 0R resistors added to set baudrate at DART channel A
    [IO.brd, IO.sch]
2025-03-12 UART reconfigured after adding hardware baudrate generator
2025-03-13 Local version of drivers and libraries used by BIOS created to save space. BIOS now uses own set of local variables. Dependency from bootloader removed. Memory rearanged.
2025-03-14 Fix in CF card driver for CP/M BIOS
2025-03-14 Write optimized (first sector of new track)
2025-04-28 Bug in CPU board fixed
    [Z80.brd, Z80.sch]
2025-09-05 Revert "Z80 version of bootloader code generated"
    This reverts commit 0d694d46e492795432687681be2e0b371d8f6f75.
    [bootloader_z80.asm, cf_z80.asm, utils_z80.asm]
2025-09-08 Bootloader rewritten in Z80 assembly
2025-09-09 Porting bootloader to Z80 assembly (work in progress)
2025-09-09 Differences between 8080 and Z80 code fixed
    [utils_z80.asm]
2025-09-10 Porting CP/M BIOS to Z80 assembly
2025-09-11 LD A, 00H replaced with XOR A to preserve memory and CPU cycles
    [bios_z80.asm, bootloader_z80.asm, cf_z80.asm]
2025-09-11 CP 00H replaced with OR A
    [bios_z80.asm, bootloader_z80.asm, cf_z80.asm, utils_z80.asm]
2025-09-13 CP/M bios rewritten in Z80 assembly. Now it generates binary identical to 8080 version. Baseline for firther optimizations
2025-09-14 Bug in READ procedure fixed
    [bios_z80.asm]
2025-09-14 LD A, 0 replaced with XOR A
    [bios_z80.asm, utils_z80.asm]
2025-09-14 Instructions encoded with opcodes replaced with proper mnemonics
    [utils_z80.asm]
2025-09-14 CRC16 in common/utils_z80.asm replaced with Z80 optimizedversion
    [utils_z80.asm]
2025-09-16 Minor optimizations in Z80 utils and cf driver
2025-09-22 Termorary workaround for deferred write issue
    [bios_z80.asm]
